kejar31/VoronMods/Ender MGN12 StealthBurner X carriage/IMG_2766.jpeg

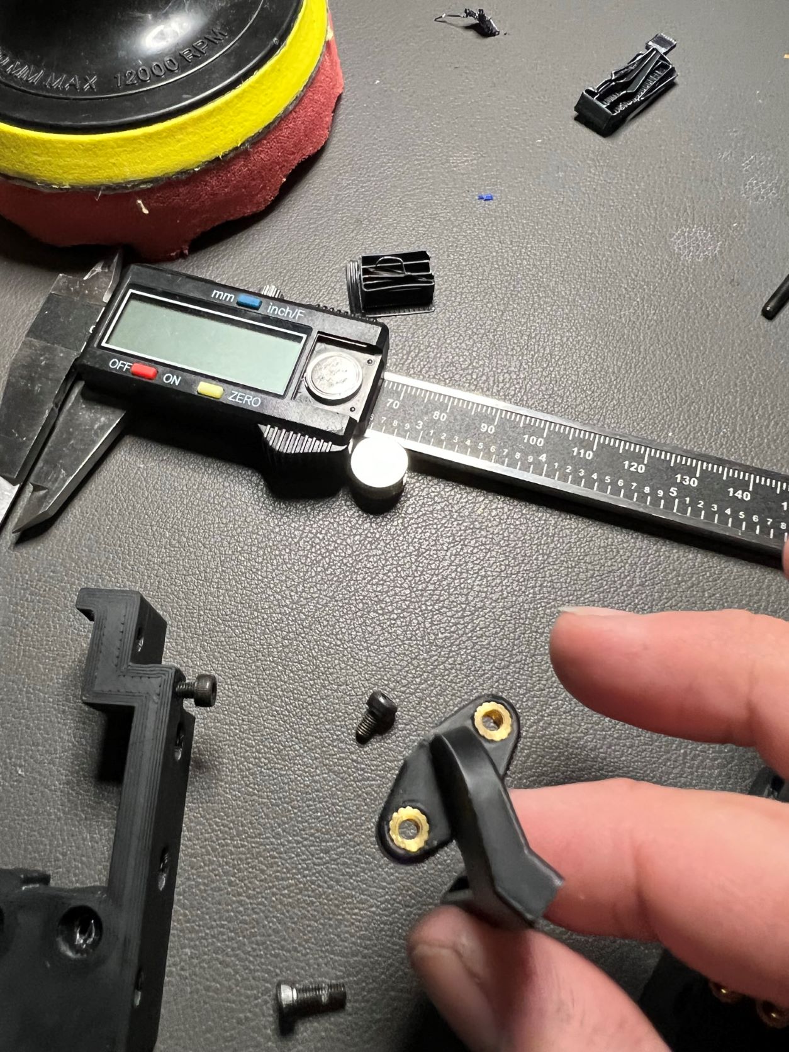
Ender MGN12 StealthBurner X carriage/IMG_2766.jpeg
