kejar31/VoronMods/Ender MGN12 StealthBurner X carriage/IMG_2769.jpeg

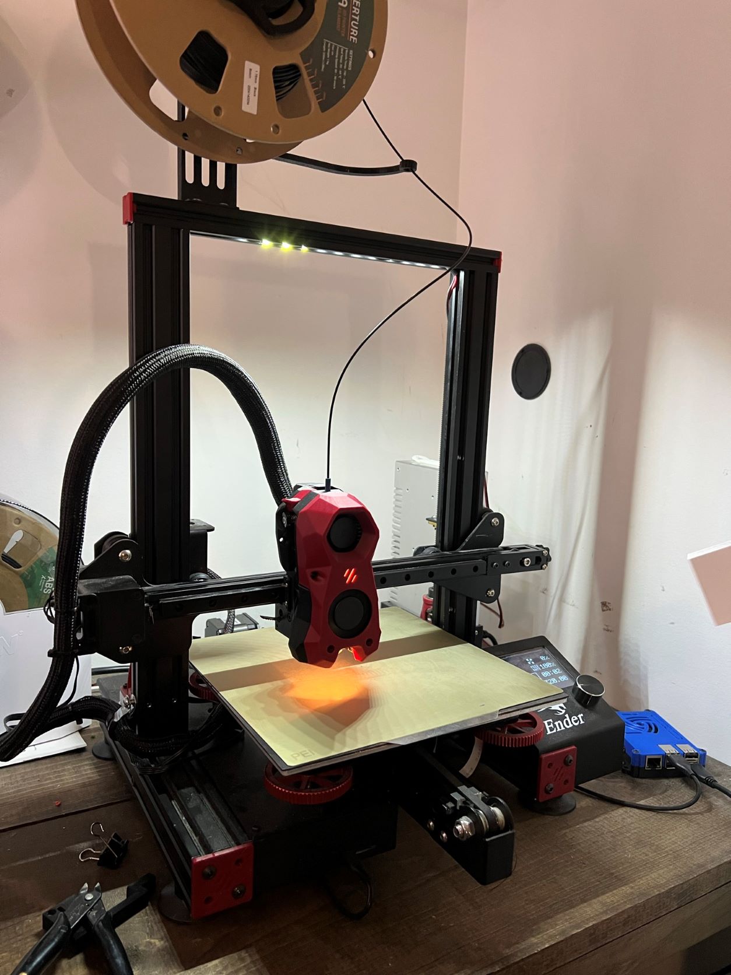
Ender MGN12 StealthBurner X carriage/IMG_2769.jpeg
