kejar31/VoronMods/CB-C2/CAD/CB-C2 V2 CW2.step

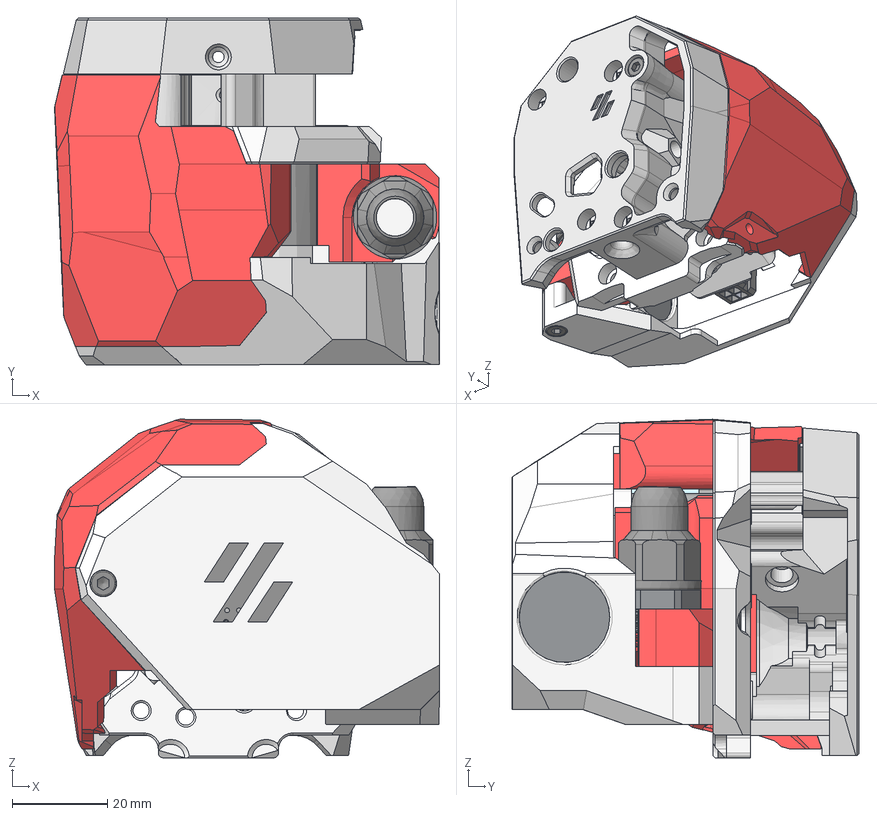
[picture p19: CAD file, 2022-12-22]
CB-C2/CAD/CB-C2 V2 CW2.step
80.8 x 72.8 x 71.0 mm
M3 THREADED INSERT x 8
Cable Cover V2
ISO 4762 - M3 x 8
PG7 Gland
Cable Gland Mount V2
ISO 7380-1 - M3 x 6
Cable Gland Sealing Nut V2
ISO 7380-1 - M3 x 8 x 2
ISO 7380-1 - M3 x 4 x 2
ISO 4762 - M3 x 12
ISO 4762 - M3 x 35
M3 Nut
Spacer 2x V2 x 2
PCB Mount V2
EBB36 V2
Door V2
ISO 4762 - M3 x 6
ISO 4762 - M3 x 16
2010 Fan
main_body
motor
motor_plate
