kejar31/VoronMods/CB-C2/STLs/A Drive Umbilical Mount for v2 with Y limit Switch.stl

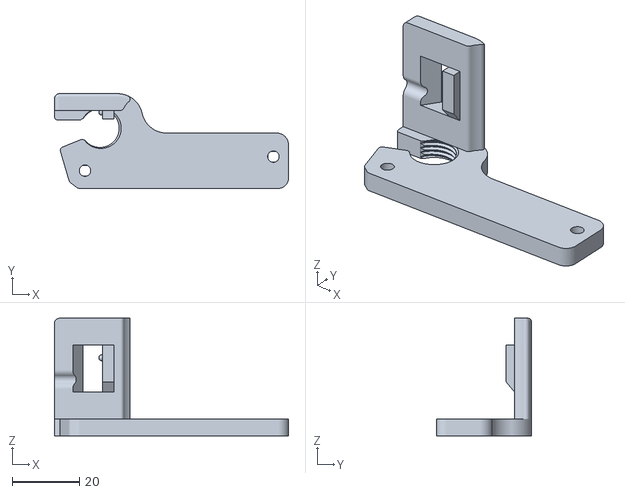
[picture p20: CAD file, 2023-01-01]
CB-C2/STLs/A Drive Umbilical Mount for v2 with Y limit Switch.stl
69.7 x 28.2 x 35.0
