kejar31/VoronMods/EBB36 Mount for CW2/EBB36 mount for CW2.stl

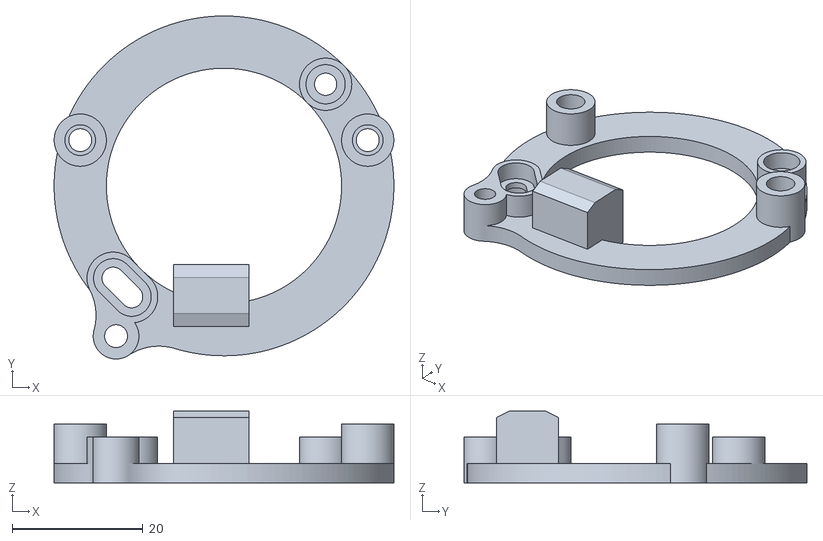
[picture p21: CAD file, 2022-07-07]
EBB36 Mount for CW2/EBB36 mount for CW2.stl
52.0 x 52.5 x 11.0
