kejar31/VoronMods/Ender MGN12 StealthBurner X carriage/e3_stealthburner_beltclip_right.stl

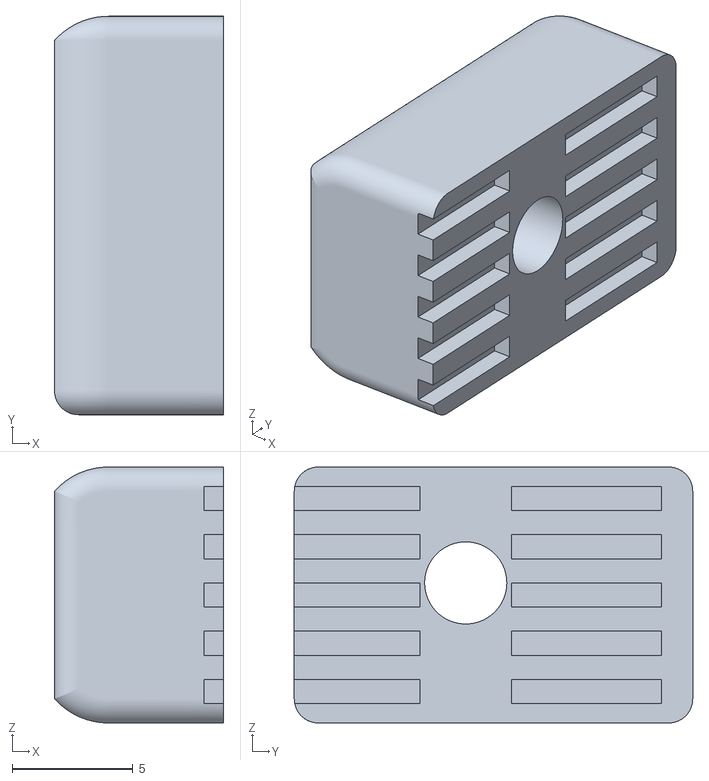
[picture p22: CAD file, 2022-06-05]
Ender MGN12 StealthBurner X carriage/e3_stealthburner_beltclip_right.stl
7.00 x 16.5 x 10.6
