kejar31/VoronMods/Geordi Lightbar/CAD/Geordi SW LightBar.step

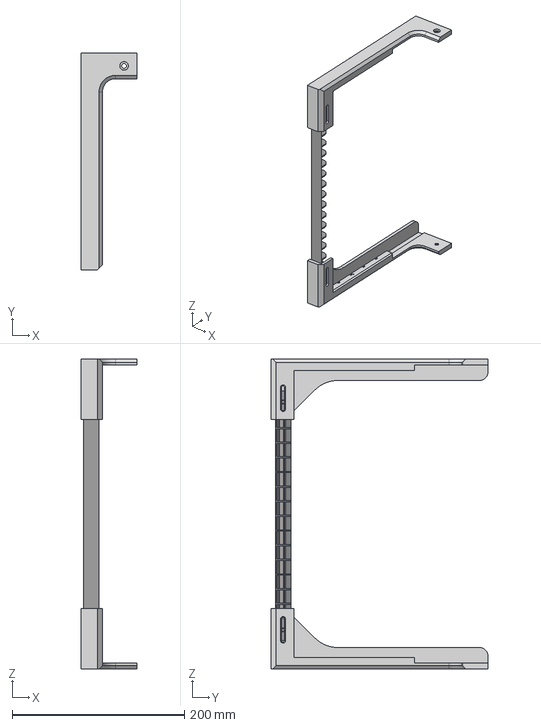
[picture p23: CAD file, 2022-10-05]
Geordi Lightbar/CAD/Geordi SW LightBar.step
65.0 x 252.0 x 360.0 mm
