kejar31/VoronMods/Geordi Lightbar/STL/Geordi LightBar.stl

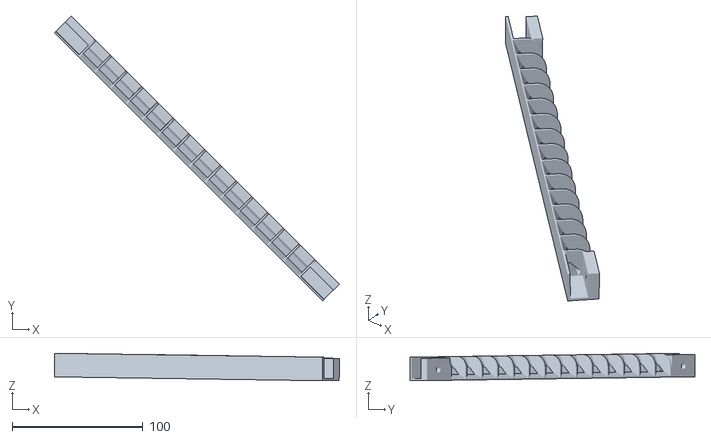
[picture p24: CAD file, 2022-10-05]
Geordi Lightbar/STL/Geordi LightBar.stl
217.7 x 217.7 x 21.0
