kejar31/VoronMods/StealthBurner CW Galileo 1 PCB cover/SBCWG1 PCB Cover.stl

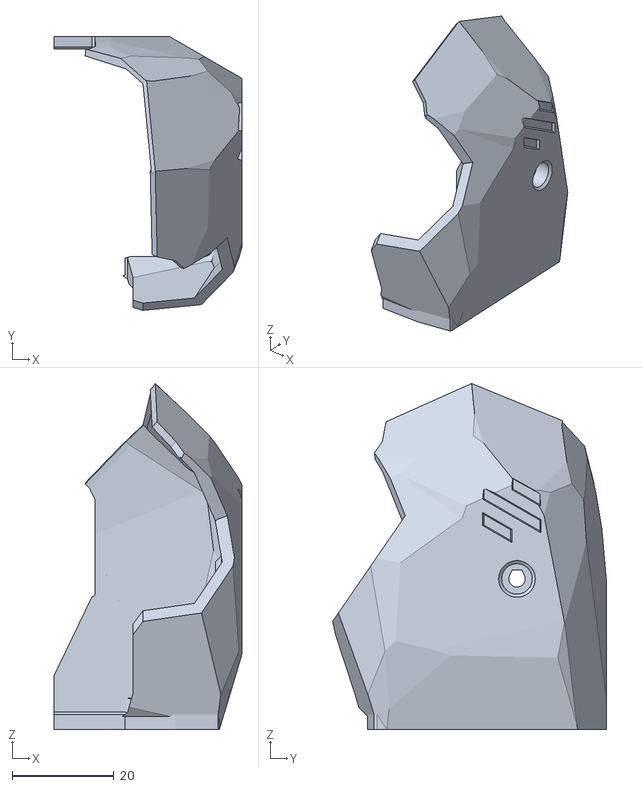
[picture p25: CAD file, 2022-06-06]
StealthBurner CW Galileo 1 PCB cover/SBCWG1 PCB Cover.stl
37.0 x 53.9 x 68.1
