kejar31/VoronMods/CB-C2/CAD/A Drive Umbilical Mount for V2.step

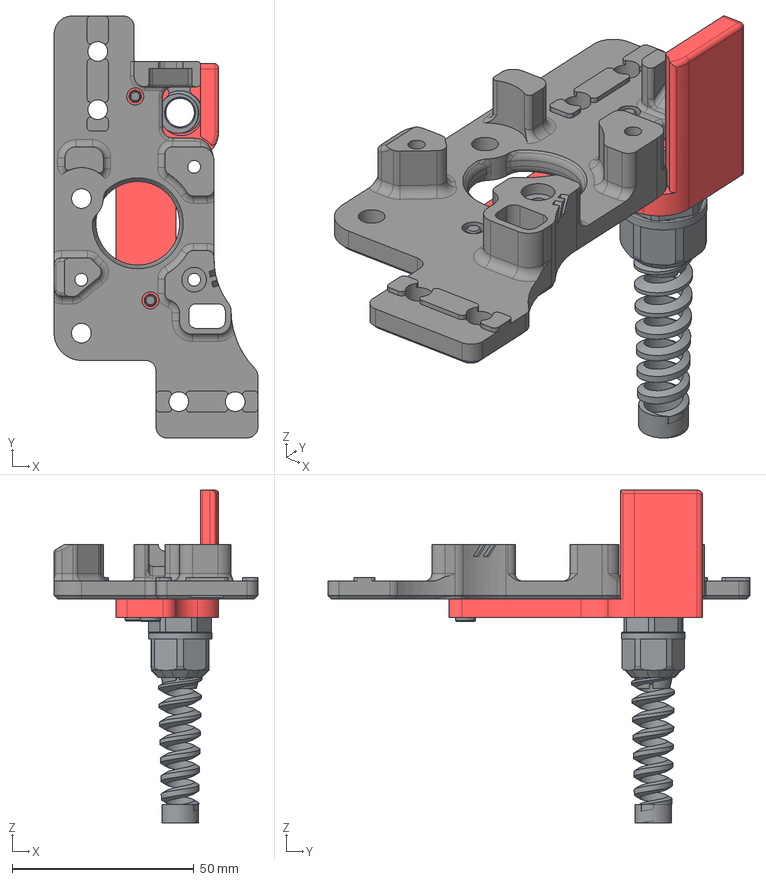
[picture p26: CAD file, 2022-12-22]
CB-C2/CAD/A Drive Umbilical Mount for V2.step
56.0 x 116.0 x 91.5 mm
A Drive Frame Upper
Cable Gland Sealing Nut
ISO 4762 - M3 x 8 x 2
A Drive Umbilical Mount for v2
PG7 Gland
