kejar31/VoronMods/CB-C2/STLs/CB-C2 V2 - Spacers MOONS 2x.stl

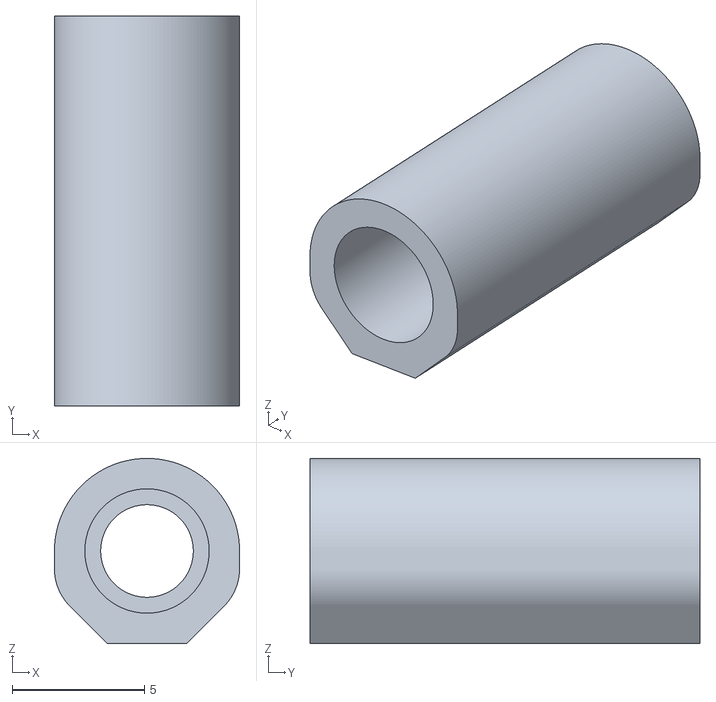
[picture p27: CAD file, 2022-12-27]
CB-C2/STLs/CB-C2 V2 - Spacers MOONS 2x.stl
7.00 x 14.7 x 7.00
