kejar31/VoronMods/EBB36 Mount for CW2/M15 cable Gland Mount for CW2.stl

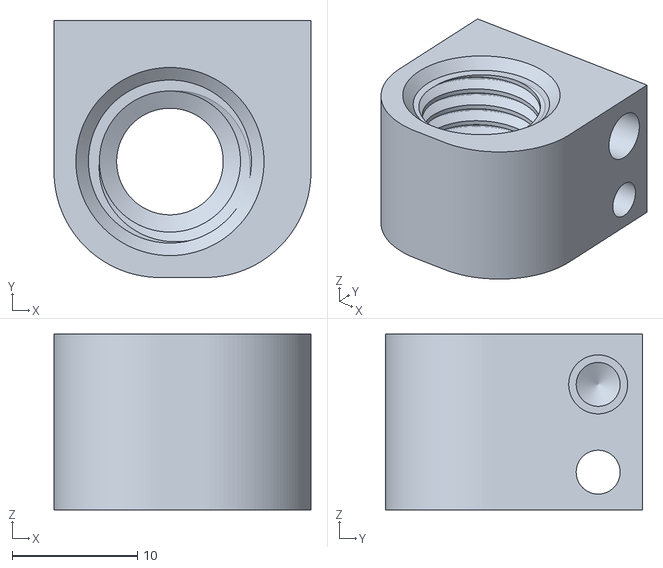
[picture p28: CAD file, 2022-07-07]
EBB36 Mount for CW2/M15 cable Gland Mount for CW2.stl
20.5 x 20.5 x 14.0
