kejar31/VoronMods/Ender MGN12 StealthBurner X carriage/e3_stealthburner_linear_right v1.stl

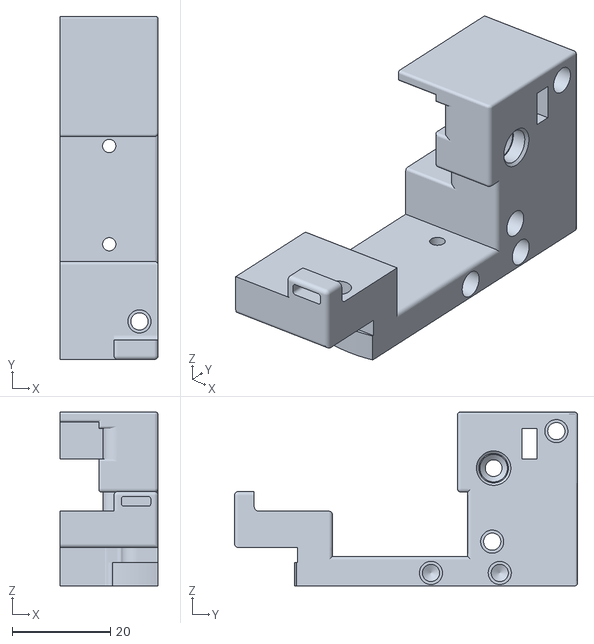
[picture p29: CAD file, 2022-06-05]
Ender MGN12 StealthBurner X carriage/e3_stealthburner_linear_right v1.stl
20.0 x 69.8 x 35.4
