kejar31/VoronMods/Geordi Lightbar/STL/Geordi LB Right.stl

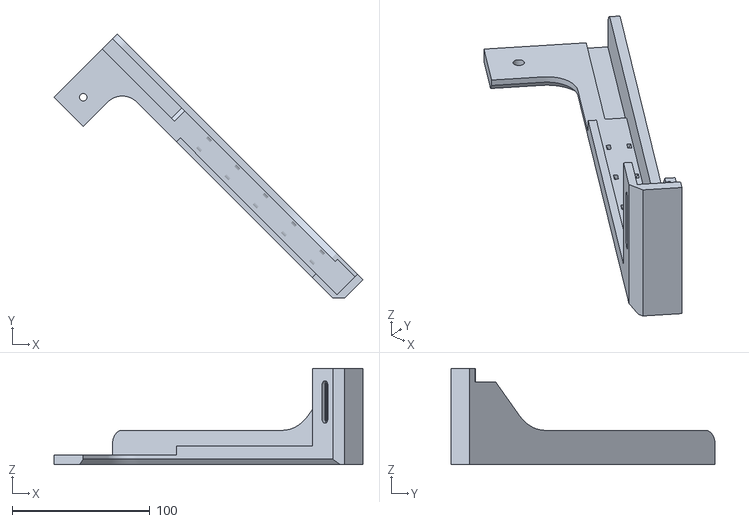
[picture p30: CAD file, 2022-10-05]
Geordi Lightbar/STL/Geordi LB Right.stl
224.1 x 191.6 x 70.0
