kejar31/VoronMods/CB-C2/STLs/CB-C2 V2 - Spacer 2x.stl

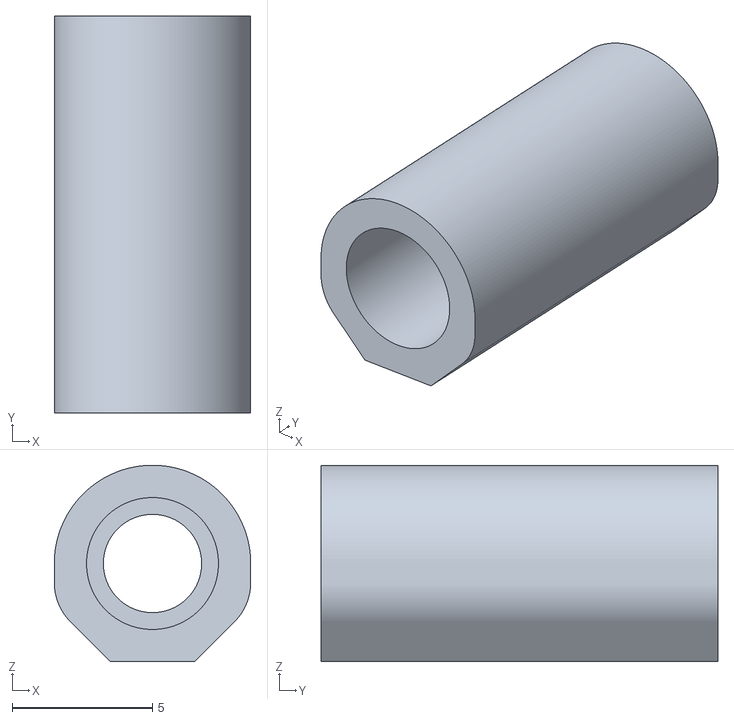
[picture p31: CAD file, 2022-12-22]
CB-C2/STLs/CB-C2 V2 - Spacer 2x.stl
7.00 x 14.1 x 7.00
