kejar31/VoronMods/StealthBurner CW Galileo 1 PCB cover/sb_cw1_pcb_cover_clip-on_mount-r1.stl

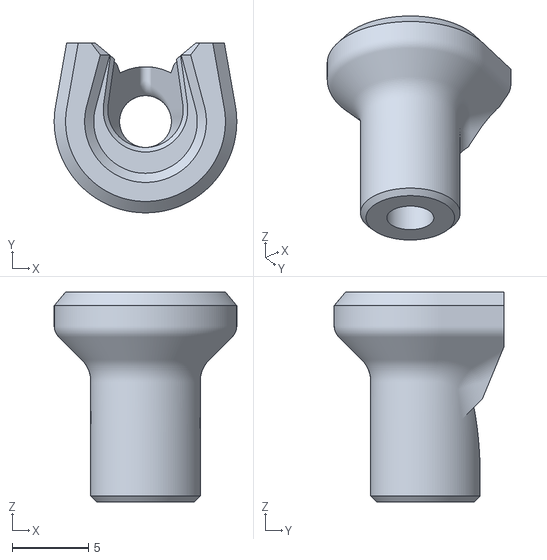
[picture p33: CAD file, 2022-06-05]
StealthBurner CW Galileo 1 PCB cover/sb_cw1_pcb_cover_clip-on_mount-r1.stl
12.0 x 11.1 x 13.8
