kejar31/VoronMods/CB-C2/STLs/CB-C2 V2 - LGX PCB Mount.stl

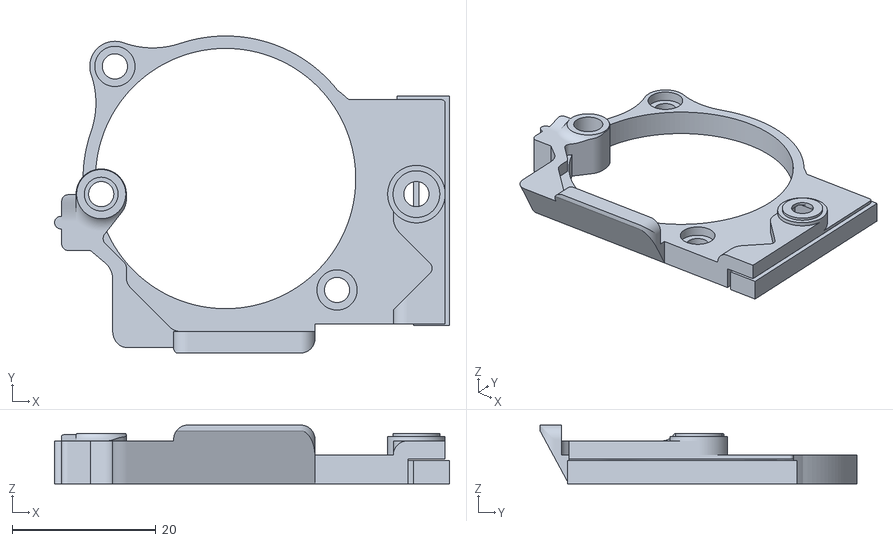
[picture p34: CAD file, 2022-12-22]
CB-C2/STLs/CB-C2 V2 - LGX PCB Mount.stl
54.9 x 44.1 x 8.20
