kejar31/VoronMods/CB-C2/STLs/CB-C2 V2 - PCB Mount.stl

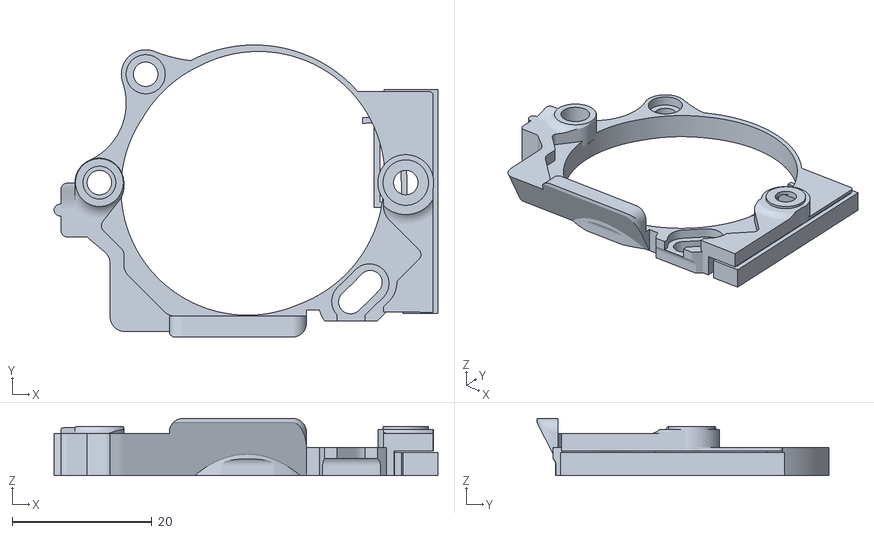
[picture p35: CAD file, 2022-12-22]
CB-C2/STLs/CB-C2 V2 - PCB Mount.stl
55.0 x 41.8 x 8.20
