kejar31/VoronMods/Ender MGN12 StealthBurner X carriage/e3_stealthburner_bltouch_mount v1.stl

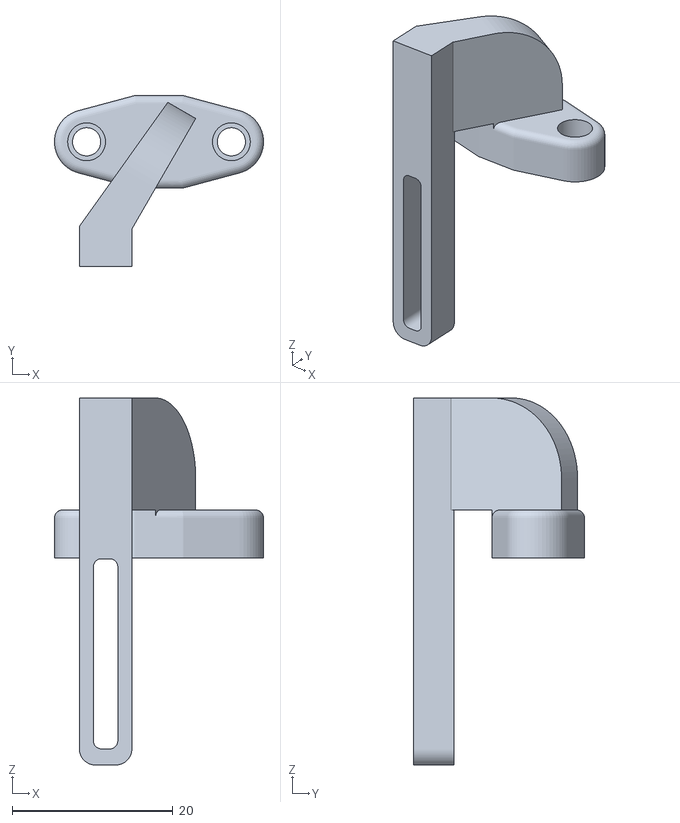
[picture p36: CAD file, 2022-06-05]
Ender MGN12 StealthBurner X carriage/e3_stealthburner_bltouch_mount v1.stl
26.0 x 21.3 x 45.6
