kejar31/VoronMods/CB-C2/STLs/CB-C2 V2 - Cable Gland Mount.stl

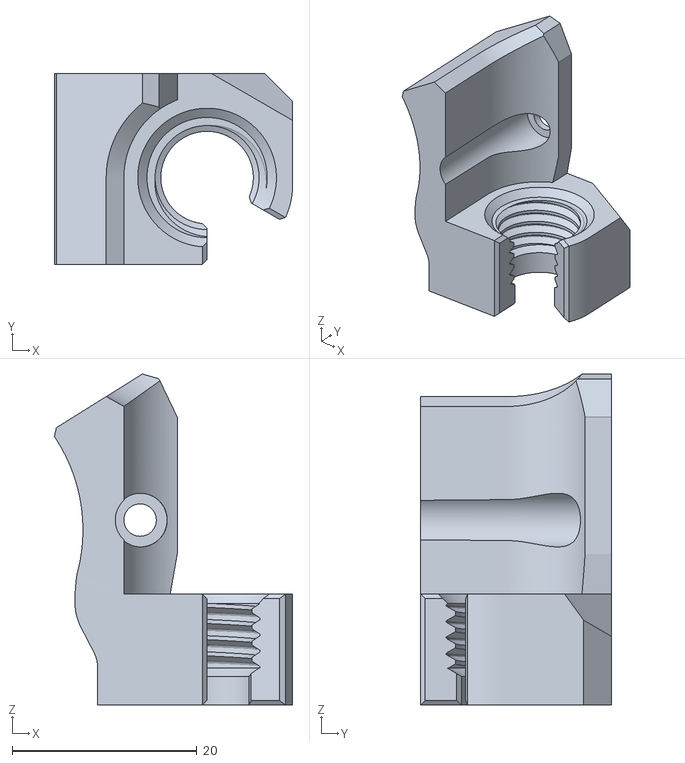
[picture p37: CAD file, 2022-12-22]
CB-C2/STLs/CB-C2 V2 - Cable Gland Mount.stl
25.8 x 20.6 x 35.8
