kejar31/VoronMods/CB-C2/STLs/CB-C2 V2 - LGX Spacer 2x.stl

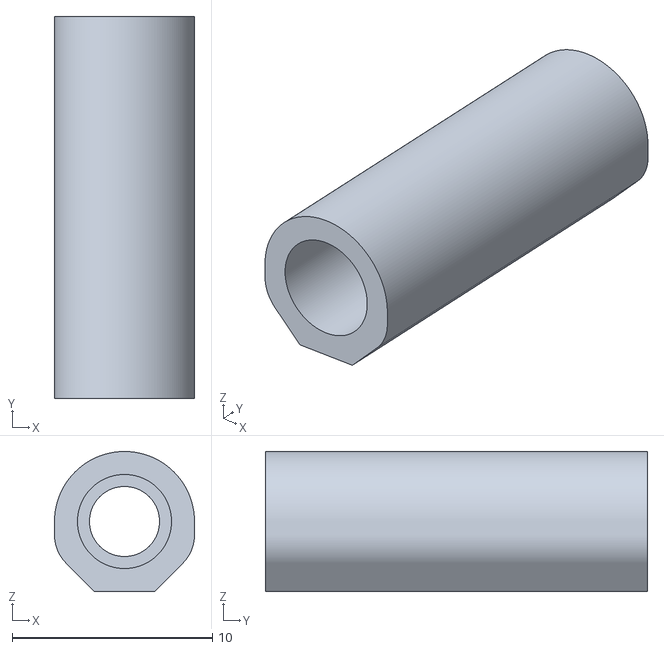
[picture p38: CAD file, 2022-12-22]
CB-C2/STLs/CB-C2 V2 - LGX Spacer 2x.stl
7.00 x 19.1 x 7.00
