kejar31/VoronMods/CB-C2/STLs/CB-C2 V2 - Cable Cover.stl

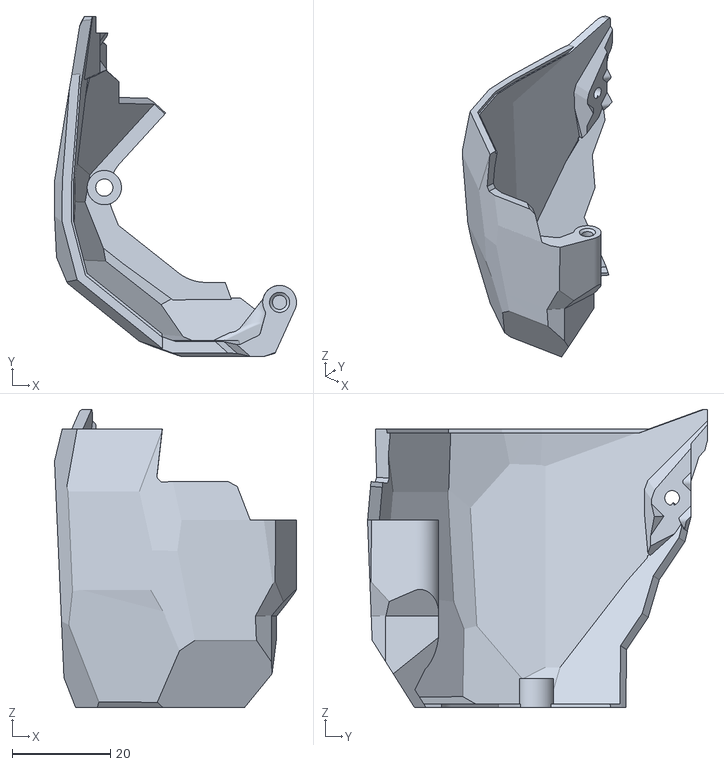
[picture p39: CAD file, 2022-12-22]
CB-C2/STLs/CB-C2 V2 - Cable Cover.stl
49.4 x 69.4 x 60.9
