kejar31/VoronMods/CB-C2/STLs/CB-C2 V2 - Door.stl

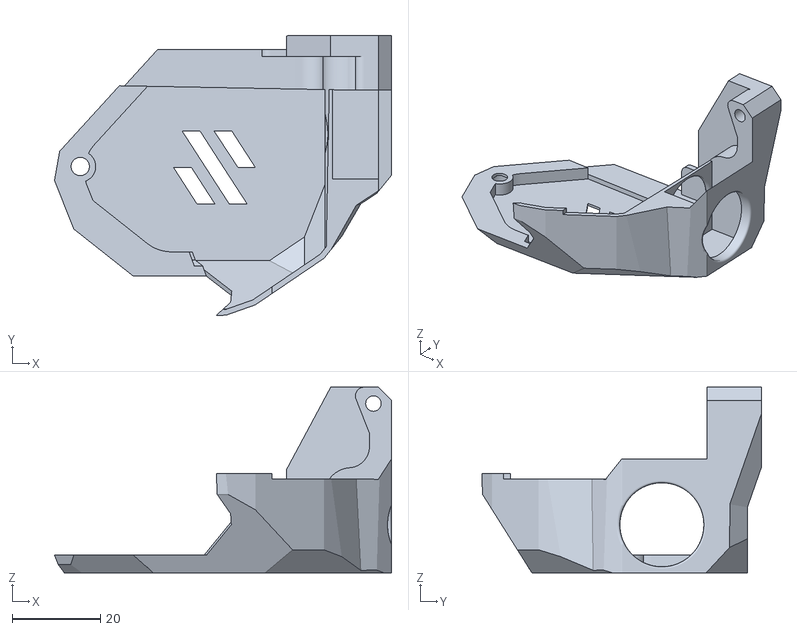
[picture p40: CAD file, 2022-12-22]
CB-C2/STLs/CB-C2 V2 - Door.stl
76.4 x 63.3 x 42.1
