kejar31/VoronMods/(list of files, cad)

Other CAD files:
StealthBurner CW Galileo 1 PCB cover/SBCWG1 PCB.step
Geordi Lightbar/STL/Geordi LB Left.stl
Ender MGN12 StealthBurner X carriage/e3_stealthburner_beltclip_left.stl
CB-C2/STLs/A Drive Umbilical Mount for v2.stl
