kejar31/VoronMods/(threads)

Thread 2 (2022-07-22):

Unsupported Overhang Holes

Alexander-T-Moss, 2022-07-22:
Firstly, I'm loving this project, and am really excited to get it installed sooner than later :) But I think the printability of the models can be improved by adding built in bridging support on the overhanging holes ( see photo attached )

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

kejar31, 2022-07-23:
Maybe… I will consider it but have not really had an issue on the two holes this effects myself

kejar31, 2022-08-03:
I fixed this on the latest release. closing

Closed 2022-08-03.

Thread 3 (2022-08-01):

Gland M12

RickDnamps, 2022-08-01:
I don't know if it just me but my Gland  M12 is not working

I try ti use this part: https://www.amazon.ca/gp/product/B07R7759BW/ref=ppx_yo_dt_b_asin_title_o00_s00?ie=UTF8&psc=1

There is not enough place to screw the second part which support the cable.

Do you think it's possible to know what is your part number or where you get it.

Thx

kejar31, 2022-08-01:
This was tested and built around the ones from DFH which at their widest point are 18mm. Sorry I can’t buy every gland and test … I do plan on releasing a new version that will include a gland (minus strain relief)

Closed 2022-08-01.

Thread 4 (2022-08-02):

Not working with motor 36STH20

RickDnamps, 2022-08-02:
This MOD is not working with the motor 36STH20.

This concept is done arround all standard part (I think, maybe I'm wrong). If you have some mod example Stealth Burner GALILEO extruder with 36STH20 that mod won't work.

I'm not saying that to complain, but more for information for other people. I think this support is very nice looking and the guys who develop it done a good job.

kejar31, 2022-08-03:
I am confused, are you saying it won’t work with this motor? If so why not? Or are you saying this won’t work with Galileo?

RickDnamps, 2022-08-03:
The space is not enough to clear the 36STH20 ... Which motor you have ?

RickDnamps, 2022-08-03:
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

kejar31, 2022-08-03:
Wait.. there is plenty of room for the motor so long as you use CW2 and not Galileo... I mean I say this is for CW2 right in the name

RickDnamps, 2022-08-03:
OK Sorry Kejar31, you right with the Clockwork2 without the galileo spacer you should be OK! !!
So for The Galileo forget that guys !!

kejar31, 2022-08-03:
Well the cad is right there… if you want it for something else you are free to take it and do what you need.

Closed 2022-08-03.

Thread 6 (2022-08-06):

PG9 gland version

JonathanHeinz, 2022-08-06:
I think a PG9 gland version would be nice, to use bigger cables for the umbilical.

kejar31, 2022-08-07:
That would be harder than it sounds… The PG7 at 18mm in diameter bearly fits as it is… The cable gland would probably have to be a custom one.

JonathanHeinz, 2022-08-07:
Maybe if we lift up the side component higher that the motor, than on top should be enough space for for a PG9 gland

Thread 7 (2022-08-15):

Can't Get Connector Through Cable Gland Mount

Alexander-T-Moss, 2022-08-15:
I don't know if this is a "me" issue but when I was installing my CB-C2 I had to cut the molex connector off one end of the harness I was using to get it through the cable gland mount as the 4 pin molex connector for the EBB36 won't go through the cable gland mount. So would it be possible to modify the mount to have a cutout in the side of it so once I unscrew the cable gland, the harness will slide in and out through the side? ( I played around in CAD and will test it out when I reprint the parts in PCCF )

[Modified Cable Gland.zip](https://github.com/kejar31/VoronMods/files/9336785/Modified.Parts.zip)

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

kejar31, 2022-08-15:
Humm this isn’t a bad idea… I will test this out later and may implement it.. will def give you credit etc

Alexander-T-Moss, 2022-08-15:
As a quick bodge I just cut a section out of the original one I had installed and there doesn't seem to be any issue with it. Unfortunately I'll not be able to test out printing it with the cutout as I'm now away from my printer for two weeks :)

Alexander-T-Moss, 2022-09-03:
Having tested the alternate cable gland mount I can verify it works without issue :)
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

kejar31, 2022-12-20:
As I am looking to do and upgrade to this project.. I am going to give this a good look.. if used you will have solved an annoying issue. Thank you sir!

Alexander-T-Moss, 2022-12-20:
No problem 🙂

kejar31, 2022-12-22:
I did end up using this, thank you again good sir

Closed 2022-12-22.

Thread 8 (2022-08-16):

[CB-C2] Gland Size

whi-tw, 2022-08-16:
I've been trying to locate a M12 gland with strain relief (not in US, so DFH isn't all that useful), and have been having trouble finding one - M12 glands seem to be M12 on one side, and M16 on the other.

https://github.com/kejar31/VoronMods/issues/6#issuecomment-1207303850 refers to PG7, which makes a lot more sense, as the PG-threaded glands seem to have the same thread on each side.

Can you please confirm if PG7 is actually the correct size, and if so, could this be added to the BOM?

whi-tw, 2022-08-16:
Just spotted #3. Seems to be the same issue I had with https://www.amazon.co.uk/gp/product/B07QHSRB45.

I have just started a return, and have ordered https://www.amazon.co.uk/gp/product/B07QPXF3WC, and will update when I receive it on Thursday.

It might be that it 'fits', but the pitch isn't correct (if you modelled it for M12 specifically). If so, it could be worth making a PG7 variant of the part?

kejar31, 2022-08-16:
You need to make sure that the gland is never had a larger circumstance than 18mm

kejar31, 2022-08-17:
Ahh that can easily be fixed in onshape…

Sent from my iPhone

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

whi-tw, 2022-08-19:
Seems this was a non-issue. PG7 fits A-OK in the existing thread.

whi-tw, 2022-08-19:
I've made [a test part in Onshape](https://cad.onshape.com/documents/024c7f542f5bf9c0c1133d19/w/99e2428d6a55f5207931fce5/e/6c30153d0c7476fda1efc462), and have made the two possible threads.

Can confirm that the two glands I have are PG7 (the one that fits in the space in CB-C2) and MG12x1.5 (the one that is too girth to fit properly).

whi-tw, 2022-08-19:
PG7-threaded part is [in this doc](https://cad.onshape.com/documents/10a4b08bf39b40b13f7e0b3b/w/03e87fb5e724d9d7011ed651/e/ac55cbcf553b9b071bcf298b). Untested, but presumably it'll work, as it's got the same thread characteristics as my test part.

whi-tw, 2022-08-20:
Confirmed, fits perfectly.

Closed 2022-12-20.

Thread 9 (2022-12-04):

20mm fan

marsb007, 2022-12-04:
The Sunon 20mm fan is extremely loud and annoying. Frankly to the point of being unusable. I've also found it hard to get it to work on the probe pins. It works on 5v + GND (always on) but when I move it to 5v + PB9 and configure in klipper, it won't turn on. I essentially can't turn it down at all.

I see that the space is rather tight where the fan currently is, but you could fit a 30mm fan (also easier to source and probably quiter) on the opposite side door/cover (where the Hartk PCB would normally be and where the SB2040 is).

kejar31, 2022-12-04:
Idk mine is not that loud… I personally run mine on a 5v and have the ground shared with the hotend fan… this allows for it to shut off when the printer is not in use Sent from my iPhoneOn Dec 4, 2022, at 8:48 AM, marsb007 ***@***.***> wrote:
The Sunon 20mm fan is extremely loud and annoying. Frankly to the point of being unusable. I've also found it hard to get it to work on the probe pins. It works on 5v + GND (always on) but when I move it to 5v + PB9 and configure in klipper, it won't turn on. I essentially can't turn it down at all.
I see that the space is rather tight where the fan currently is, but you could fit a 30mm fan (also easier to source and probably quiter) on the opposite side door/cover (where the Hartk PCB would normally be and where the SB2040 is).

—Reply to this email directly, view it on GitHub, or unsubscribe.You are receiving this because you are subscribed to this thread.Message ID: ***@***.***>

morph5555, 2022-12-19:
@marsb007

https://github.com/HyperToxic33/EBB-Fan-Control

kejar31, 2022-12-20:
yes I have seen that mod but again I am not having any issues with noise on my fan its actually quieter than my hot end fan... Then considering that I am just sharing the ground with my hotend fan its not running unless its printing and like I said the hotend fan is louder.. You may have a knock-off maglev IDK... closing this issue

Closed 2022-12-20.

Thread 10 (2023-01-01):

Amendments to the manual

kkardashian, 2023-01-01:
- Would it be possible to have a diagram showing what needs to be cut off the EBB mount? With the integral supports and brims it's a bit confusing.
- Installing the extenders nearly impossible after the gland mount is installed, IMO they should come first in the process
- What voltage is the 2010 fan and where can you plug it? The board only has 2 x 24v fan outs..

Thread 11 (2023-01-01):

Make mount thicker and use heat insert

kkardashian, 2023-01-01:
IMO the board mount is so thin, it bends all over the place. Possibly the cables could force the board against the screws creating a short. Would it be possible to make it a few layers thicker? That way it would support the gland better and could also use heat insert for mounting the board instead of the hex nut.

kejar31, 2023-01-01:
Yes it’s thin but once installed on the spacers and supported by the cable gland mount it is actually pretty strong… there is very little to no chance of it flexing once fully assembled.. Have you fully assembled the mount and attached it to CW2 with the cable gland and the PCB board? If so can you provide pictures of what flex you are talking about?

Also I didn’t want to use the m3 nut either but in order to fit a heated insert I would need to increase the depth of the mount by 2 to 3 mm which would then limit the space between the mount and the rear door by 2 to 3 mm’s

kejar31, 2023-01-01:
Here I went to my 2.4 that I am working on atm that has the mount installed and tried to flex the mount by pressing down on the pcb… as you can see in the video, the pcb flexes but that mount does nothing

https://youtube.com/shorts/aoWPJteSKDs?feature=share

again if you have a picture of video of your issue please post it, otherwise I will close this in the next few days

kkardashian, 2023-01-01:
I tightened the crews as much as I could it's not too bad indeed and the screw head isn't directly underneath pins. Okay, I'll cancel this..

kkardashian, 2023-01-01:
.

Closed 2023-01-01.

Thread 12 (2023-01-05):

How to control the fan with a pin

Pjeran, 2023-01-05:
First - great design - love how it integrates into the original SB design.  Not an issue, but an addition to the great design.

At first I just pulled the 5V for the fan off the I2C connector but this left the fan on all the time.  Having a fan that runs all the time when the printer is powered on regardless of if it is printing was just bothering me.  I put together a little cable with an 2N7000 MOSFET that allows me to turn the fan on and off using the PB3 pin on the EBB36.  I used a 330 ohm resistor on the gate because it is what I had lying around, but any low resistance will work to keep the gate current inrush low when the MOSFET turns on.

Just in case anyone wants to control the fan.

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

danielfmo, 2023-02-18:
I like this, I'm doing it but... how can one fit the DuPont connectors into the EBB? the lid does not close.

Pjeran, 2023-02-18:
Had to give a bit of a downward bend to the Dupont pins.  Just had to go slow.

ChaosBlades, 2023-04-05:
Or you could just buy a 24v 2010 fan and crimp both the hotend and 2010 fans into the same connector like I did. Looks like only one manufacturer makes a 24v 2010 fan. I see them on Aliexpress and eBay. Below is a link the the exact one I bought. Ended up getting 3 just in case I needed a replacement and could not find another. It seems to be holding up after over a hundred hours worth of printing I just would not have your hotend fan run below anything under 100% as none of these 2010 fan push much air and would be virtually useless at less than 100%.

https://www.ebay.com/itm/175500018119?var=474821533001

Here is a picture of it in case the above link dies and you need to hunt around for this exact fan.
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

ChaosBlades, 2023-05-03:
Disregard my last comment. The 24v 2010 fans do not last I am already on my 3rd.

I have opted to go fanless. With 50C chamber temps and 9x9x12mm heatsinks (same one as included in EBB36 kit) on both the stepper driver and MCU the MCU levels out at or just below 80C with a spec at 110C as acceptable temperatures. So this is perfectly safe as far as the spec is concerned. If you are running a chamber temp of around 70C+ then you are probably going to want to run a fan. Most people prefer to not use CAN BUS at these chamber temps anyways. Run_Current on extruder is 0.7 and I have not had any skipped steps.

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

I have included a modded No Fan Cable Door and Rear Door. I have....

- Reduced printed overhang angles to 45 degrees or more so you don't need as much cooling for a nice print
- Reinforced the heatset hole on the Cable Door
- Improved gap between Rear Door and Cable Door at the top
- Changed the hole on the Read Door to accept the same M3x6mm Button Head as the Cable Door uses so you don't need two hex keys to open the doors. The bolt head is still recessed.
- Enlarged the Voron Logo on the Rear Door as large as possible to allow more air flow.
- Filled the Voron Logo on the Rear Door with hex mesh to prevent cables from popping out.
- Removed a bunch of weird geometry that didn't need to exist.

Attached is both step and 3mf files.
[Fanless Doors.zip](https://github.com/kejar31/VoronMods/files/11381511/Fanless.Doors.zip)

kejar31, 2023-05-24:
ATP I run fan-less too but just leave the back door off for that... Have not had an issue and have been doing it for a while..

kejar31, 2023-05-24:
Also while probably not electrically sound  ( I am no electrical eng) I have just tied the ground in with the 24volt line on my hotend cooling while using a 5v header off another location on the board.. this worked fine for me without issue
