kejar31/VoronMods/(commit log)

2022-07-07 initial upload
    This is the initial upload and is still very much beta... Use at your own risk
    [EBB36 mount for CW2.stl, M15 cable Gland Mount for CW2.stl]
2022-07-15 Update Readme.md
    added link to kit included donate button
2022-07-15 add cad images
2022-07-15 Add STLs
    [CB-C2 - Mount B1.stl, CB-C2 - Spacer B1.stl]
2022-07-15 Add CAD
    [CB-C2.step]
2022-07-16 Update CAD for Beta 2
    [CB-C2.step]
2022-07-16 Remove as it is not needed anymore
    [CB-C2 - Spacer B1.stl]
2022-07-16 Update STLs for Beta 2
    [CB-C2 - Mount.stl]
2022-07-16 updated BOM for Beta2
    nothing was added so just one insert and the M3x12 was removed.. Kit should still be compatible.
2022-07-17 Beta 4 update for CAD
    Very early update, have not printed this yet, use at your own risk
    [CB-C2 Beta 4.step]
2022-07-18 Fixed Door and EBB36 Mount
    fixed a few things that I missed during the latest rebuild.. Still have not even printed this one so use at your own risk.
    [CB-C2 Beta 4.1.step]
2022-07-19 fixed issue with Cable Gland Mount
    [CB-C2 Beta 5.1.step]
2022-07-20 Fixed threading on Cable gland that I forgot to add after the latest redraw
    [CB-C2 Beta 5.2.step]
2022-07-20 Cable gland update again
    added and chamfer to the edge of the mount to allow for more space for the side door to open
    [CB-C2 Beta 5.3.step]
2022-07-20 RC1 STLs
    [CB-C2 - Door RC1.stl]
2022-07-20 Need t
    [CB-C2 - Door RC1.stl]
2022-07-20 Fan press fit section was to small
    increased the size a bit
    [CB-C2 - Door RC1.1.stl]
2022-07-21 RC 1.1
    [CB-C2 RC1.1.step]
2022-08-05 Tweak to link to rear_plate for toolhead PCB
    Attempting to save someone from my mistake...
2022-10-05 inital commit
    [Geordi LB Left.stl, Geordi LB Right.stl, Geordi LightBar.stl, Geordi SW LightBar.step]
2022-12-22 Prep for V2
    removing old file before I upload the new ones
    [CB-C2 - Cable Cover RC2.stl, CB-C2 - Door RC2.1.stl]
2022-12-22 CB-C2 V2 initial commit
    [A Drive Umbilical Mount for V2.step, A Drive Umbilical Mount for v2.stl, CB-C2 V2 - Cable Cover.stl, CB-C2 V2 - Cable Gland Mount.stl, CB-C2 V2 - Door.stl, CB-C2 V2 - LGX PCB Mount.stl, CB-C2 V2 - LGX Spacer 2x.stl, CB-C2 V2 - PCB Mount.stl]
2022-12-27 Adding spacers for moons extruder motor
    The moons extruder motors mount is 2.4mm thick rather than 3 like the LDO so I separate spacers were needed
    [CB-C2 V2 - Spacers MOONS 2x.stl]
2023-01-01 Add A drive Cable gland mount with Y limit switch
    Created a Y limit switch mount on the rear A drive cable gland mount for V2.4's
    [A Drive Umbilical Mount for v2 with Y limit Switch.stl]
